divyansh0518/hexapod-mobile-manipulator/README.md

# Hexapod Mobile Manipulator

**A six-legged robot with an arm, built for places where wheels don't work and people shouldn't go.**

18 leg servos · arm with gripper · remote control with live video · onboard sensing

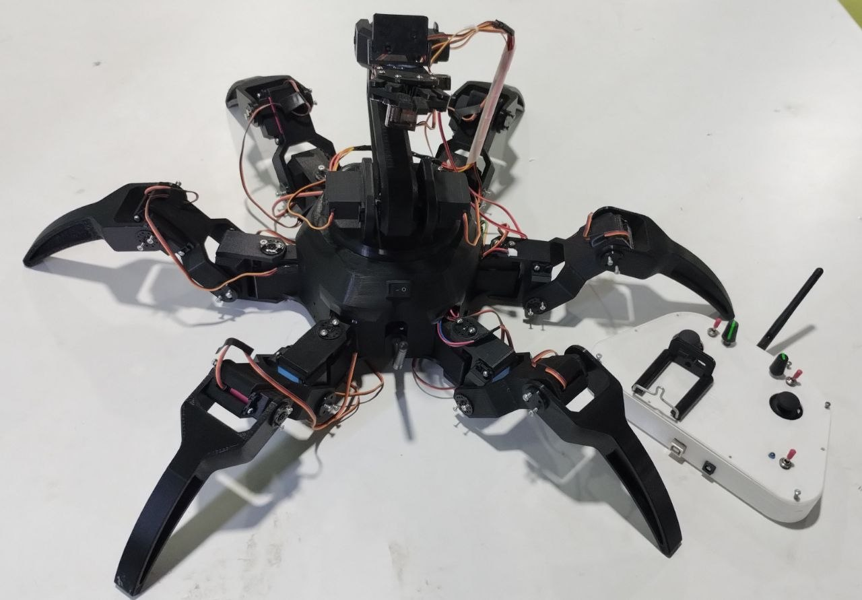
[picture p1: media/final/robot_01.jpg]
Hexapod mobile manipulator


[Hardware](docs/HARDWARE.md) · [Power system](docs/power.md) · [Controls](docs/CONTROL.md) 

---

## Why I built it

Mines, nuclear power plants, pipe-filled industrial spaces, collapsed buildings in a rescue
mission: they have the same problem for a robot. The floor is cluttered with pipes, cables, rubble and steps, and a wheeled robot gets
stopped by the first obstacle. Legs can step over things, and an arm lets the robot do
something once it gets there: move debris, press, pick up and carry a light object.

**Demo video:** https://www.instagram.com/reel/DaDLhgQxw-o/?exln=ZTF6NHNwNGUyenFh

**Building pictures:** https://drive.google.com/drive/u/7/folders/1v8lwiHUHrGsg1zEQj96tbzUH02H_Gp72

## Design Inspiration

The robot is designed around one central idea: combine animal-inspired locomotion, stability on difficult terrain, and manipulation capabilities in a single platform, The base hexapod and manipulator structure is adapted from the open-source design by Emre Kalem.

**Crab-inspired morphology:**  The wide, laterally distributed leg arrangement takes inspiration from crabs and provides a broad support base. This geometry is useful for navigating cluttered terrain where wheel-based mobility can become restrictive. The current platform uses forward walking, while sideways crab locomotion remains a future extension.

**Insect-inspired locomotion:**  The robot uses an alternating tripod gait, inspired by the walking patterns of insects such as ants and cockroaches. Legs 0, 2 and 4 alternate with legs 1, 3 and 5, creating alternating three-leg support phases for coordinated movement.

**Integrated manipulation:**  Unlike a conventional hexapod, this platform carries a robotic arm and gripper on its upper body. The legs handle terrain traversal while the arm enables object interaction. The arm folds over the chassis during locomotion to maintain a compact configuration.
### References 

1. **Chen, Y. et al. (2022).** [Sideways crab-walking is faster and more efficient than forward walking for a hexapod robot.](https://doi.org/10.1088/1748-3190/ac6847) *Bioinspiration & Biomimetics, 17(4).*

2. **Full, R. J. & Tu, M. S. (1990).** [Mechanics of six-legged runners.](https://doi.org/10.1242/jeb.148.1.129) *Journal of Experimental Biology, 148, 129–146.*

3. **Ting, L. H., Blickhan, R. & Full, R. J. (1994).** [Dynamic and static stability in hexapedal runners.](https://doi.org/10.1242/jeb.197.1.251) *Journal of Experimental Biology, 197, 251–269.*

4. **Mahapatra, A., Roy, S. S. & Pratihar, D. K. (2019).** [Study on feet forces' distributions, energy consumption and dynamic stability measure of hexapod robot during crab walking.](https://doi.org/10.1016/j.apm.2018.09.015) *Applied Mathematical Modelling, 65, 717–744.*

5. **Zheng, Y. et al. (2022).** [Different manipulation mode analysis of a radial symmetrical hexapod robot with leg–arm integration.](https://doi.org/10.1007/s11465-021-0664-0) *Frontiers of Mechanical Engineering, 17, Article 8.*
## Specifications

| | |
|---|---|
| Legs | 6 legs x 3 joints (coxa, femur, tibia), 18 x DS3235 Pro 35 kg.cm coreless metal-gear digital servos, 180 deg, 7.4 V |
| Arm | base, shoulder (2 servos), elbow, 2 wrist joints, gripper. 4 x MG996R (base, shoulder, elbow) and 3 x MG90 (wrists, gripper) |
| Main controller | Arduino Mega 2560 |
| Remote | Arduino Uno, 2 joysticks, 2 pots, toggles, 16x2 LCD, nRF24L01 |
| Camera | ESP32-CAM, MJPEG over its own WiFi network |
| Edge payload | UNIHIKER K10: camera, screen, temperature, humidity, light, accelerometer |
| Body tilt | K10 accelerometer (3-axis), used for tilt warning. |
| Power | 3S LiPo, 5200 mAh (11.1 V nominal, 12.6 V full). Three regulated rails: legs 7.4 V, arm 6.0 V, logic 5 V. See [docs/power.md] |
| Firmware | Arduino C++ (PlatformIO), MicroPython on the K10 |

## Build

| | | |
|---|---|---|
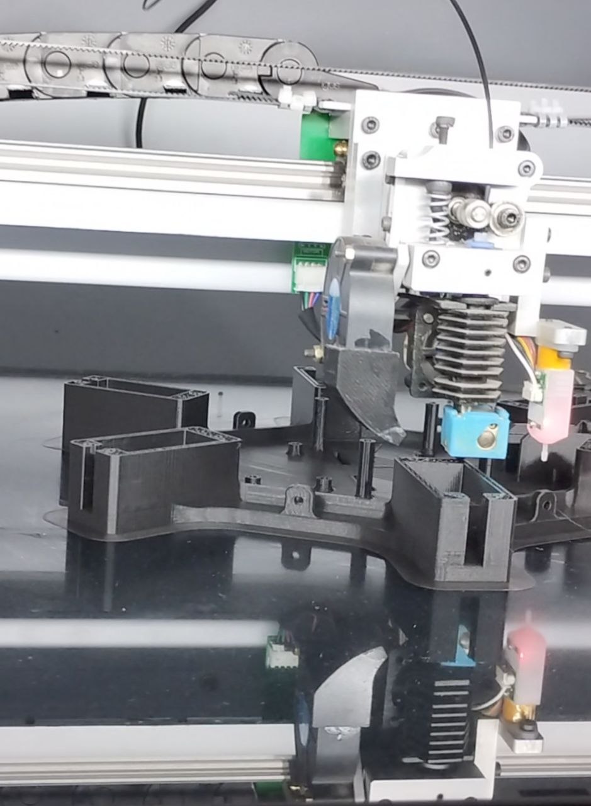
[picture p2: media/printing/printing_001.jpg]
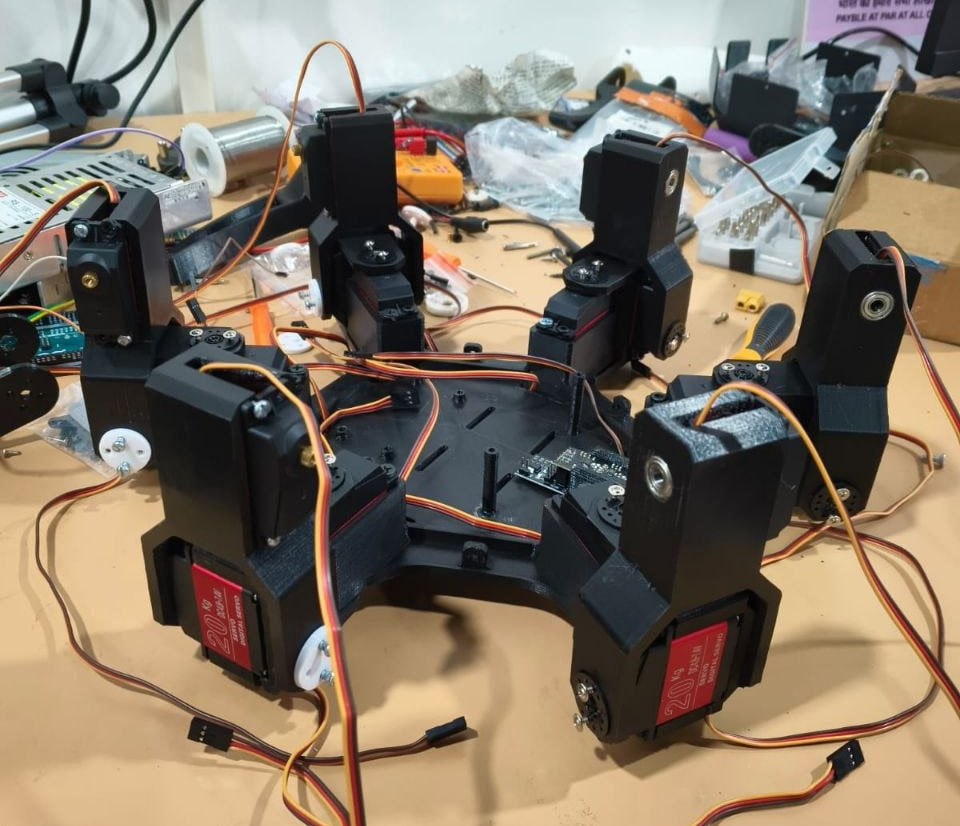
[picture p3: media/assembly/assembly_leg.jpg]
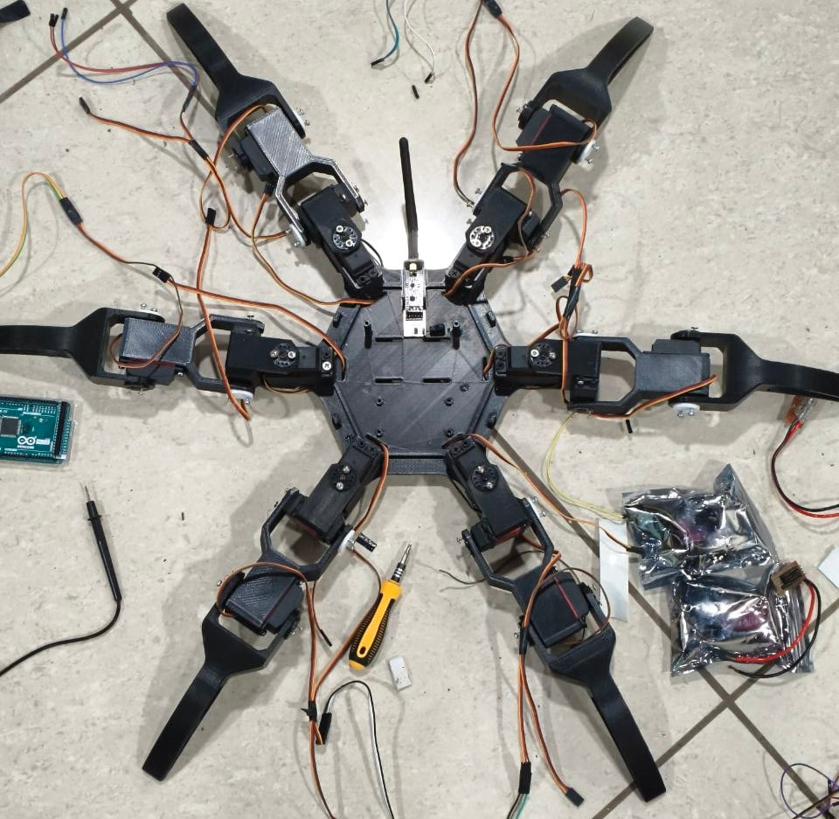
[picture p4: media/assembly/assembly_body.jpg]
|  |  |  |
| _Printing_ | _Leg assembly_ | _Body_ |
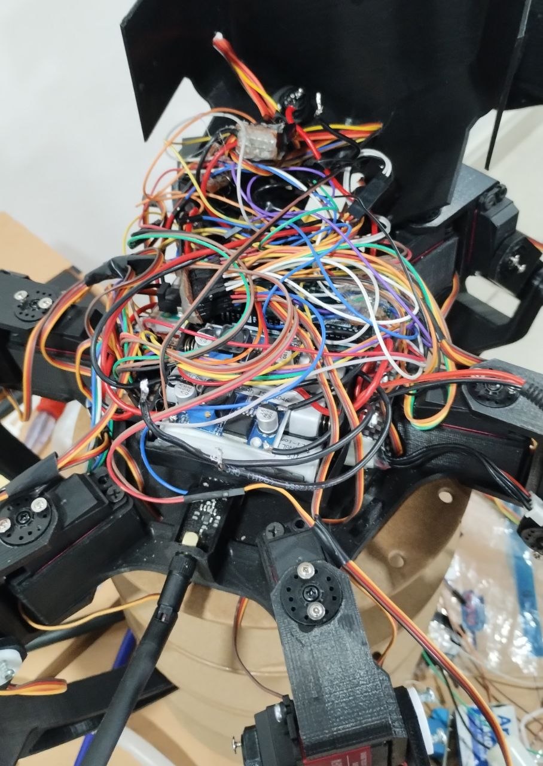
[picture p5: media/electronics/wiring_01.jpg]
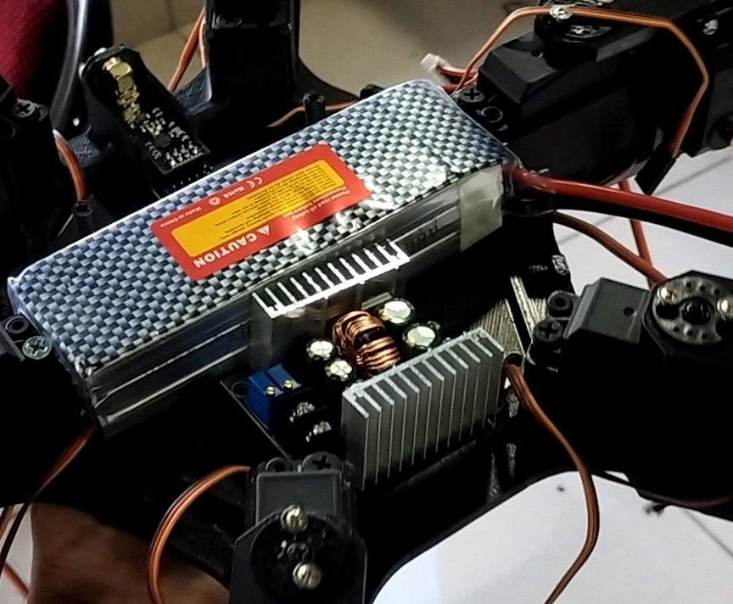
[picture p6: media/electronics/power_01.jpg]
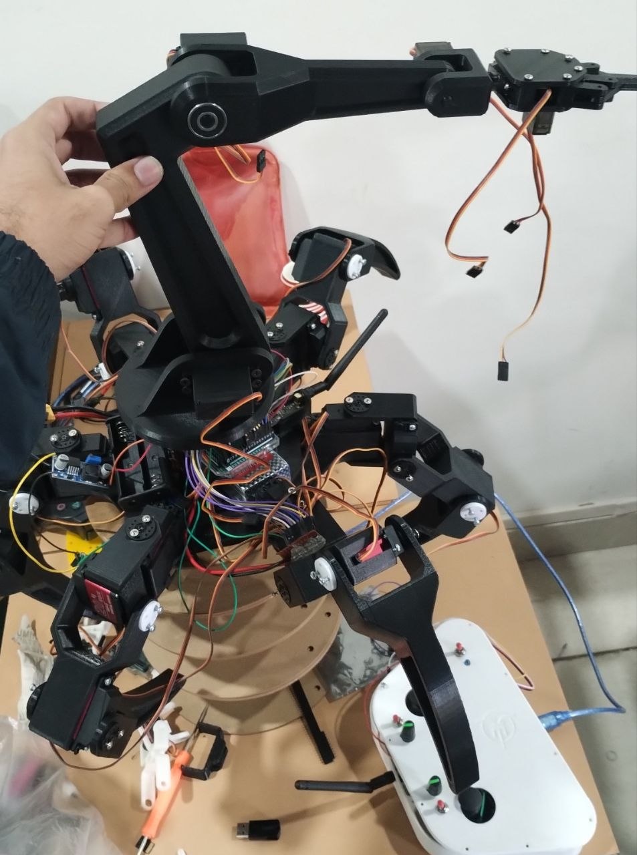
[picture p7: media/arm/arm_01.jpg]
|  |  |  |
| _Wiring_ | _Power system_ | _Arm mounted on the body_ |
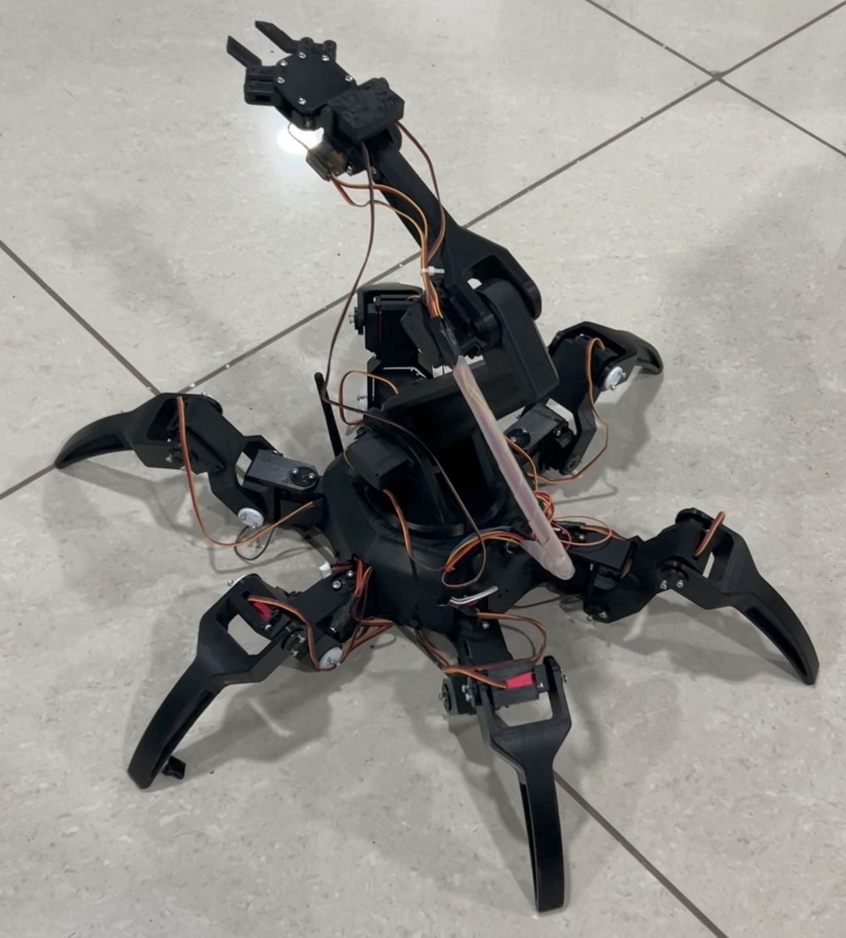
[picture p8: media/final/robot_02.jpg]
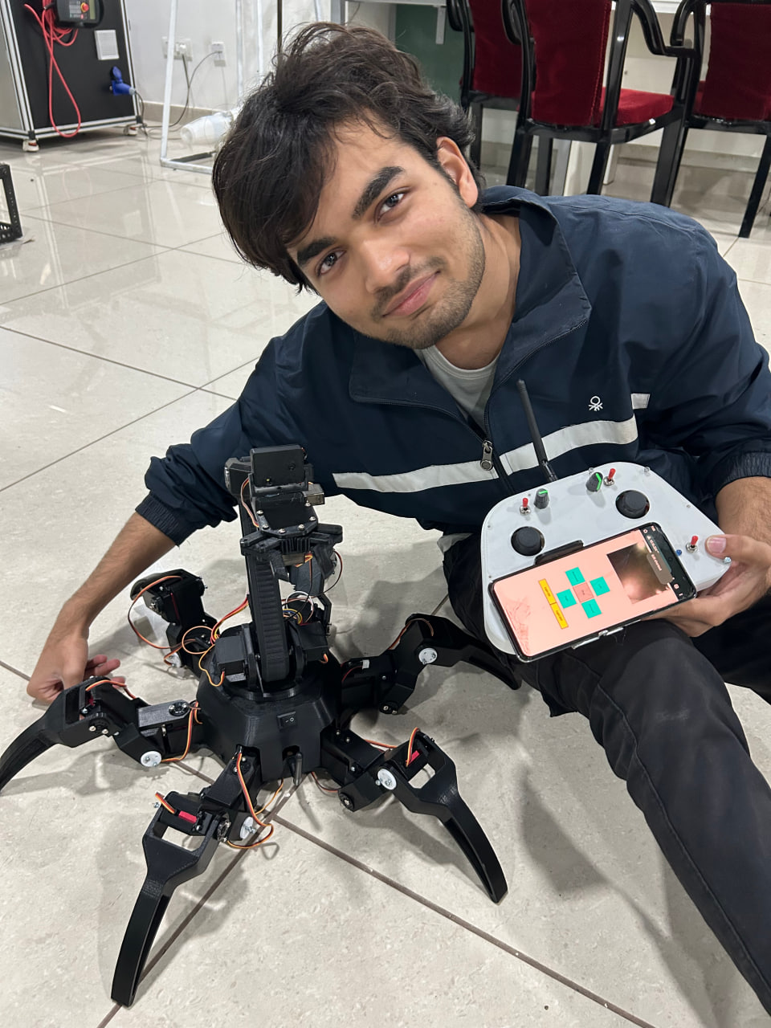
[picture p9: media/final/robot_04.jpg]
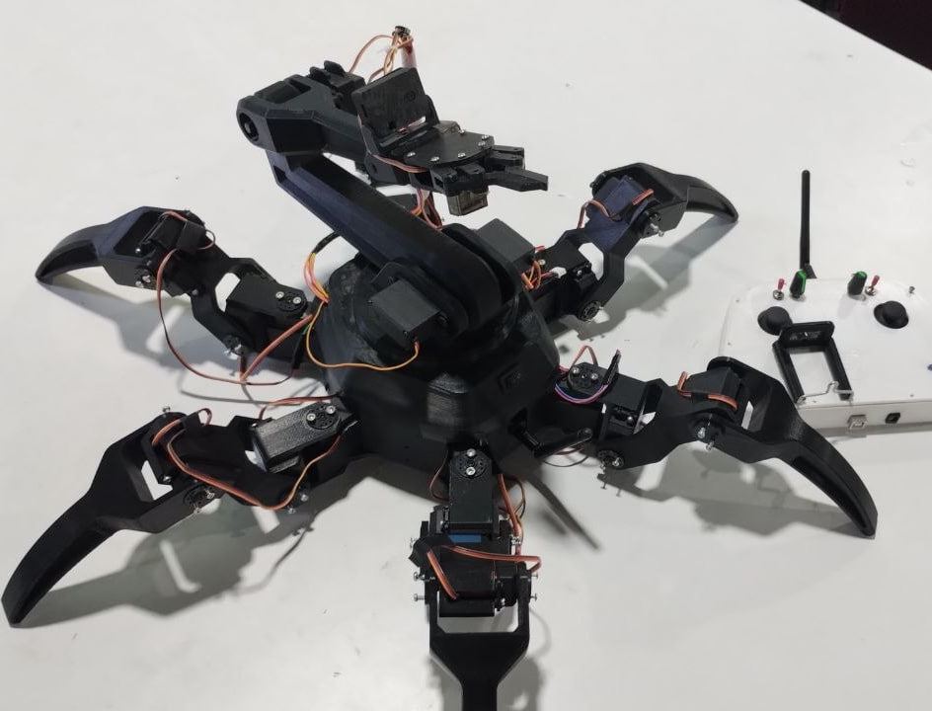
[picture p10: media/final/robot_03.jpg]
|  |  |  |
| _Finished robot_ | _Testing_ | _Close-up_ |

## System Architecture

```mermaid
flowchart TB
    subgraph CONTROL["01 · COMMAND & CONTROL"]
        R["REMOTE CONTROLLER<br/>Arduino Uno<br/>Dual Joysticks · Potentiometers · LCD"]
    end

    subgraph CORE["02 · CENTRAL CONTROL UNIT"]
        M["ARDUINO MEGA 2560<br/>Main Controller<br/>Command Processing · Servo Control"]
    end

    subgraph ACTUATION["03 · LOCOMOTION & MANIPULATION"]
        L["HEXAPOD LOCOMOTION<br/>6 Legs · 18 Servos<br/>Alternating Tripod Gait"]
        A["ROBOTIC MANIPULATOR<br/>7 Servos<br/>Arm · Wrist · Gripper"]
    end

    subgraph INTELLIGENCE["04 · ONBOARD SENSING & INTERFACE"]
        K["UNIHIKER K10<br/>ESP32-S3 · Camera · Display"]
        S["ENVIRONMENTAL & MOTION MONITORING<br/>Temperature · Humidity · Light<br/>Acceleration · Tilt Alerts"]
        K --> S
    end

    subgraph VISION["05 · WIRELESS VISUAL FEEDBACK"]
        C["ESP32-CAM<br/>Live Video Streaming"]
        V["PHONE / LAPTOP<br/>MJPEG Video Feed"]
        C -.->|"Wi-Fi Access Point"| V
    end

    R -->|"nRF24L01 · 50 Hz"| M
    M -->|"Servo Control"| L
    M -->|"Servo Control"| A
    M <-->|"UART · 3.3V TTL"| K

    classDef control fill:#183153,color:#fff,stroke:#4b83b5,stroke-width:2px
    classDef motion fill:#164e45,color:#fff,stroke:#43a68e,stroke-width:2px
    classDef sensing fill:#49345e,color:#fff,stroke:#a17ac5,stroke-width:2px
    classDef vision fill:#68451f,color:#fff,stroke:#d5a45e,stroke-width:2px

    class R,M control
    class L,A motion
    class K,S sensing
    class C,V vision

    style CONTROL fill:#18315318,stroke:#4b83b5
    style CORE fill:#18315318,stroke:#4b83b5
    style ACTUATION fill:#164e4518,stroke:#43a68e
    style INTELLIGENCE fill:#49345e18,stroke:#a17ac5
    style VISION fill:#68451f18,stroke:#d5a45e
```

## Limitations

- Walking is open loop. The K10's accelerometer is used for tilt warning only. With no gyroscope
  there is no sensor fusion and no body leveling yet.
- Video goes over WiFi and has much shorter range than the control link.
- Radiation, dust and water are not addressed. Real nuclear or mine work would need a
  hardened, sealed machine.
